abdulrahman-mansour-ce/Directional-Antenna-Controller-UAV/images/component.jpg

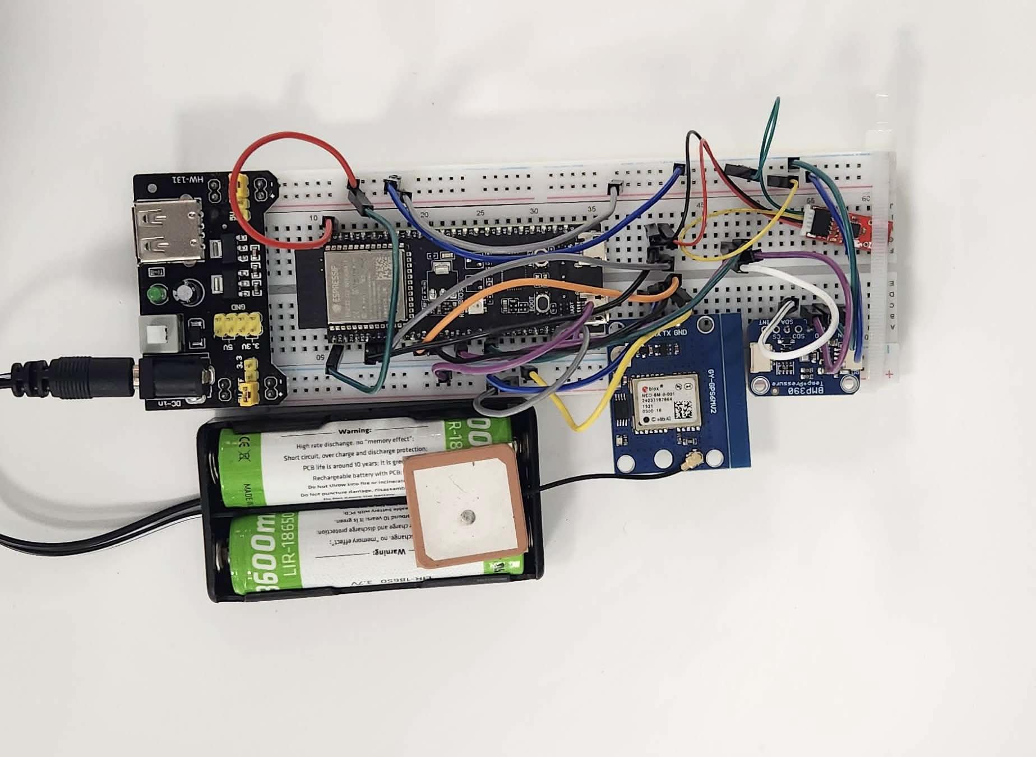
images/component.jpg
