abdulrahman-mansour-ce/Directional-Antenna-Controller-UAV/images/project.jpg

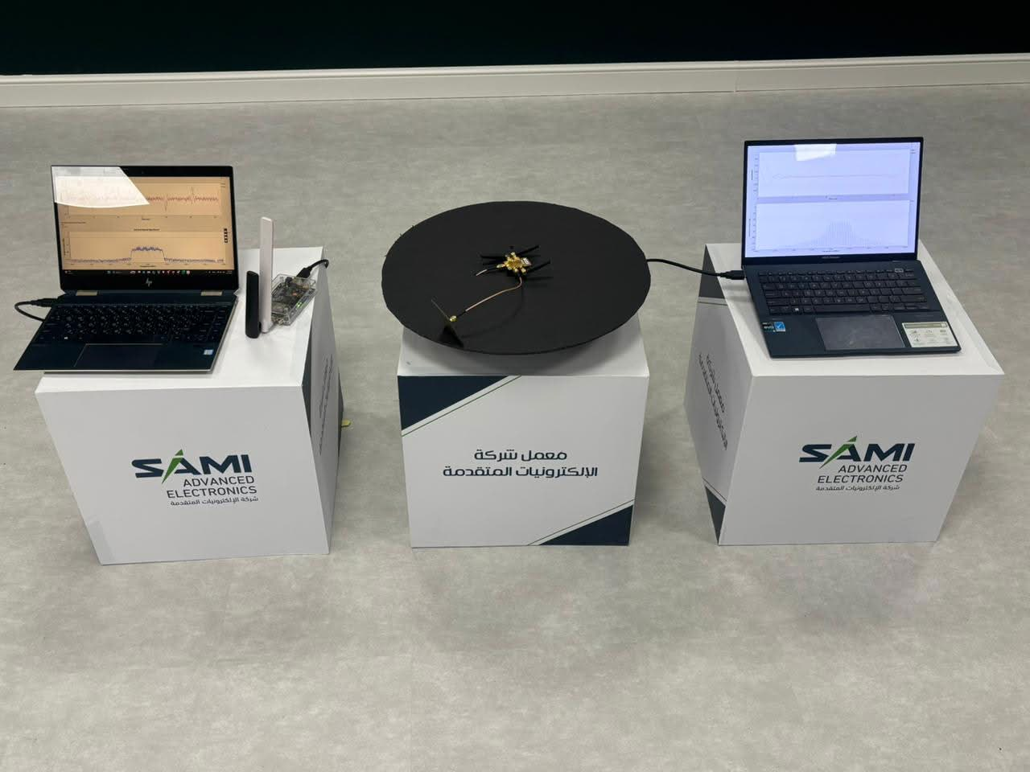
images/project.jpg
