abdulrahman-mansour-ce/Directional-Antenna-Controller-UAV/images/README.md

# Images

This folder contains system architecture diagrams, hardware setup photographs, prototype images, test results, and project illustrations.
