abdulrahman-mansour-ce/Directional-Antenna-Controller-UAV/images/overview.png

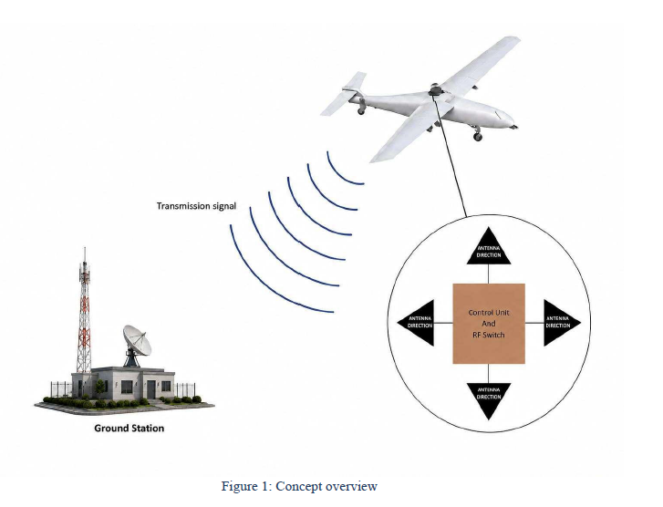
images/overview.png
