abdulrahman-mansour-ce/Directional-Antenna-Controller-UAV/images/rx.png

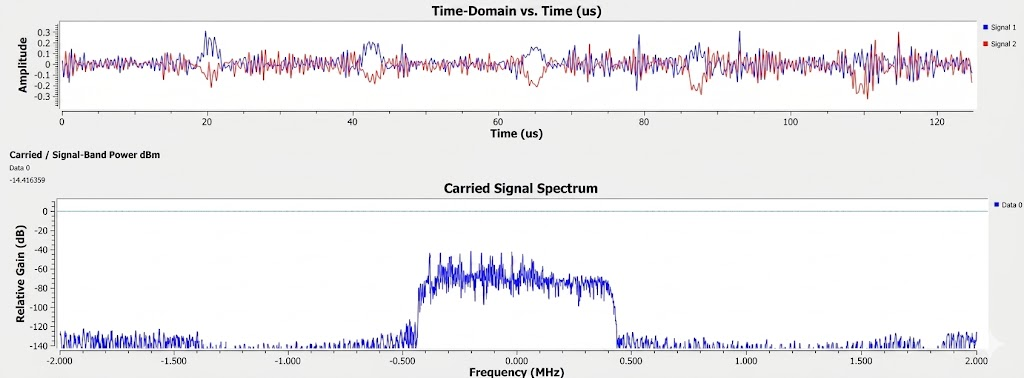
images/rx.png
