abdulrahman-mansour-ce/Directional-Antenna-Controller-UAV/images/sys.png

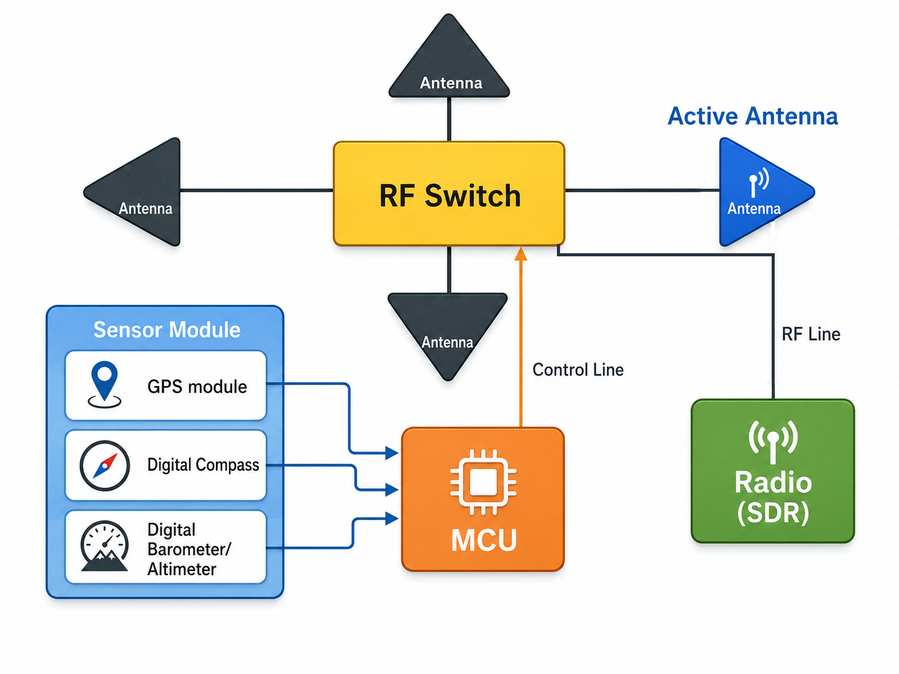
images/sys.png
