abdulrahman-mansour-ce/Directional-Antenna-Controller-UAV/images/tx.png

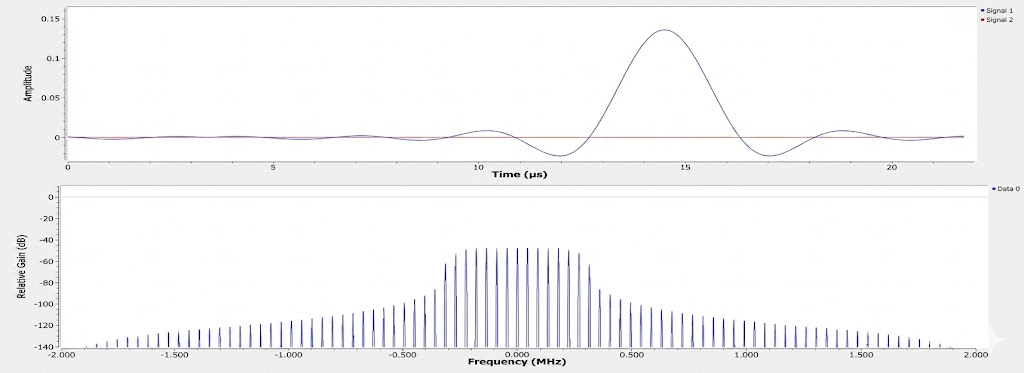
images/tx.png
